MikeFromBC/PipeOrganShutters2017/Dad_OrganShutters.sch

## EAGLE design Dad_OrganShutters.sch (2017-09-09)

Schematic: Dad_OrganShutters.sch

Parts:
PCB1: ARDUINO_UNO
R1: TRIM_US-3223G; 3223G
R2, R3, R4, R5, R6, R7, R8, R9: R-US_0204/2V; 0204V

Notes on the sheet:
IN1
MOTOR+, Blue, 72
MOTOR-, Orange, 71
Motor driver module
To Syndyne pipe driver board
12 VDC from Syndyne (tip+)
GND
+5V
+24V
24VDC power
24VDC motor
Shutter position pot
S1 LSB
S7 MSB
IN2
ENABLE A
Cable wire colors RED: +5 BLK: Gnd WHT: 40, Position fdbk ORA: 71, Motor- BLU: 72, Motor+ GRN: N/C SHLD: Gnd at controller
WHT (tag 40)
Convert from 12V "levels" from Syndyne to open collector
IN3
IN4
ENABLE B
S1-S7 all have pulldowns
Motor 1
Motor 2
MOTOR+, Blue 72
MOTOR-, Orange 71
Last modified July 16, 2017
