MikeFromBC/PipeOrganShutters2017/Shutter performance.xlsx

Sheet: open
pos | threshold
0 | 140 | 135
5 | 170 | 160
10 | 180 | 170
15 | 190 | 185
20 | 185 | 190
25 | 190 | 185
30 | 180 | 180
35 | 160 | 175
40 | 160 | 165
45 | 155 | 165
50 | 160 | 170
55 | 160 | 165
60 | 165 | 175
65 | 165 | 175
70 | 175 | 180
75 | 165 | 175
80 | 165 | 165
85 | 155 | 160
90 | 140 | 155
pos | threshold
0 | 135
5 | 160
10 | 170
15 | 185
20 | 190
25 | 185
30 | 180
35 | 175
40 | 165
45 | 165
50 | 170
55 | 165
60 | 175
65 | 175
70 | 180
75 | 175
80 | 165
85 | 160
90 | 155

Sheet: close
drive | thresh
100 | 175
95 | 170
90 | 155
85 | 145
80 | 145
75 | 150
70 | 145
65 | 155
60 | 165
55 | 165
50 | 160
45 | 155
40 | 145
35 | 130 | CLOSING
30 | 115 | spring included
25 | 110
20 | 115
15 | 120
10 | 140
5
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
