MikeFromBC/PipeOrganShutters2017/(commit log)

2017-01-02 migrate to % solve some problems calibrate
    [Dad_OrganShutters.ino]
2017-03-13 update schematic
    [Dad_OrganShutters.sch]
2017-03-13 update to allow for interjection of inverting ULN2003
    [Dad_OrganShutters.ino]
2017-07-21 rework to support 2 channels
    [Dad_OrganShutters.ino]
2017-09-09 updated schematic
    [Dad_OrganShutters.sch]
2019-09-15 change MotorEnable pin so PWM is available add some extra commands
2020-03-03 remove instance 2 of Motor object (improve system performance)
2022-08-21 add results of measurements
    [Shutter performance.xlsx]
2022-09-04 Bug fix for recent commit
    [Dad_OrganShutters.ino]
2022-09-04 apply more power to motors
